Qinyongle/hello_world/README.md

# hello_world
learn how to use github
vvbmnbm,
