Qinyongle/hello_world/(list of files, cad)

Other CAD files:
hack_clock_v1.1/滤光板/挡板1.dwg
