Qinyongle/hello_world/hack_clock_v1.1/hack_clock.pdf

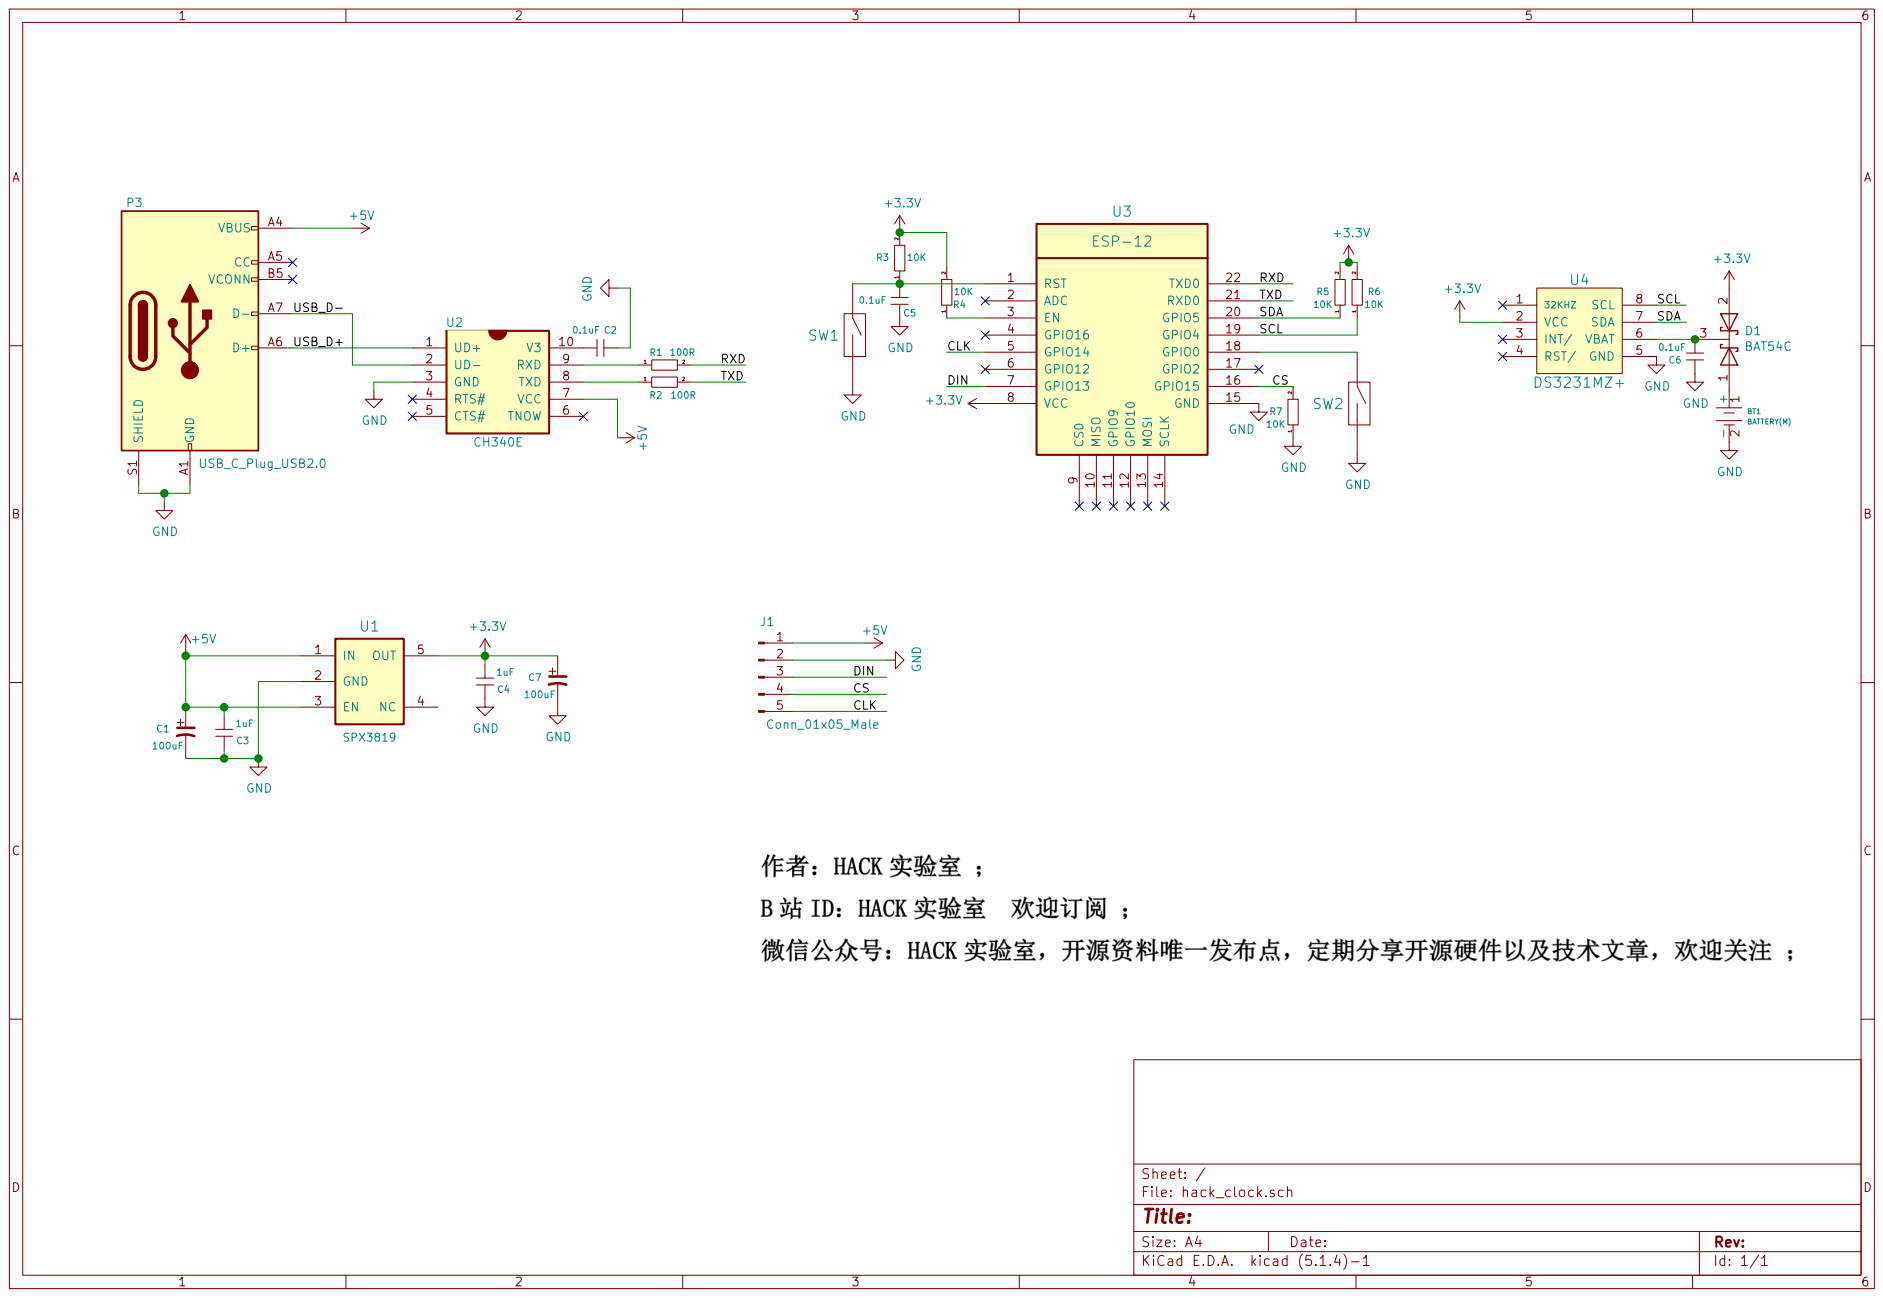
[picture p1: page 1]
