Qinyongle/hello_world/(commit log)

2021-06-20 first try
    [hack_clock-B_Cu.gbl, hack_clock-B_Mask.gbs, hack_clock-B_Paste.gbp, hack_clock-B_SilkS.gbo, hack_clock-Edge_Cuts.gm1, hack_clock-F_Cu.gtl, hack_clock-F_Mask.gts, hack_clock-F_Paste.gtp]
2021-06-20 second try
    [hack_clock-B_Cu.gbl, hack_clock-B_Mask.gbs, hack_clock-B_Paste.gbp, hack_clock-B_SilkS.gbo, hack_clock-Edge_Cuts.gm1, hack_clock-F_Cu.gtl, hack_clock-F_Mask.gts, hack_clock-F_Paste.gtp]
